thieu-b55/Easy-esp32-domotica-with-esp32-mesh/Schermafdruk_2023-03-04_16-17-45.png

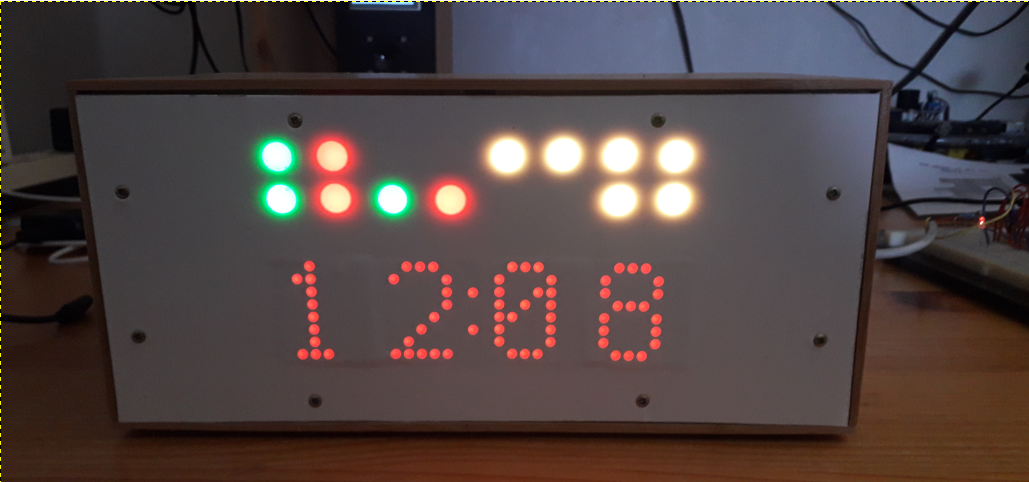
Schermafdruk_2023-03-04_16-17-45.png
