thieu-b55/Easy-esp32-domotica-with-esp32-mesh/README.md

# Easy-esp32-domotica-with-esp32-mesh

8 digital inputs

8 digital outputs

clock synchronized with NTP server

fully operable via web page

outputs can be controlled via

  day
  
  time on time off
  
  input
  
  combination of these 3
  
  manually
  
  network is build automatically, modules can be added or removed
  
  network rebuild itself
  
  Check every minute whether aal modules are still connected
  
  status of the various inputs and outputs clearly visible as well as the clock
