thieu-b55/Easy-esp32-domotica-with-esp32-mesh/Eenvoudig ESP32 domotica met ESP32 mesh netwerk.pdf

Domotica met ESP32 mesh netwerk

8 digitale ingangen
8 digitale uitgangen
klok gesynchroniseerd met NTP server volledig bedienbaar via webpagina uitgangen kunnen gestuurd worden via: – dag
– tijd
– ingang
– een combinatie van deze 3 – manueel
netwerk wordt automatisch opgebouwd, modules kunnen worden toegevoegd of verwijderd, netwerk bouwt zichzelf terug op.
Elke minuut controle of alle modules nog verbonden zijn


Status van de verschillende in en uitgangen duidelijk zichtbaar evenals de klok. Elke in- of uitgang heeft 4 mogelijkheden om weergegeven te worden,

* niet aktief | niet opgelicht
* aktief niet gestuurd (0) | groen
* aktief gestuurd(1) | rood
* aktief maar geen terugmelding | geel
van module met dit nummer

deze kleuren zijn identiek voor de webpagina


Enkele nuttige adressen

ESP32 en Arduino IDE :
https://randomnerdtutorials.com/installing-the-esp32-board-in-arduino-ide-windows-instructions/

ESP32 mesh / Hoe painlessMesh Library installeren : https://randomnerdtutorials.com/esp-mesh-esp32-esp8266-painlessmesh/#more-100202

ESP32 mesh :
https://docs.espressif.com/projects/esp-idf/en/stable/esp32/api-guides/esp-wifi-mesh.html

Dit project opgithub :
https://github.com/thieu-b55/Easy-esp32-domotica-with-esp32-mesh

ESP32 domotica

Onderdelen hoofdmodule

2 x ESP32 Devkit (ESP32 module kan niet gelijktijdig onderdeel zijn van een mesh netwerk en webserver zijn).


1x DS3231 klokmodule met SQW uitgang

1 x MAX7219 led display


Ledstrip 16 leds WS2812B
led 0 – 7 | uitgang | led 0 = uitgang 0 | led 7 = uitgang 7
led 8 – 15 | ingang | led 8 = ingang 0 | led 15 = ingang 7

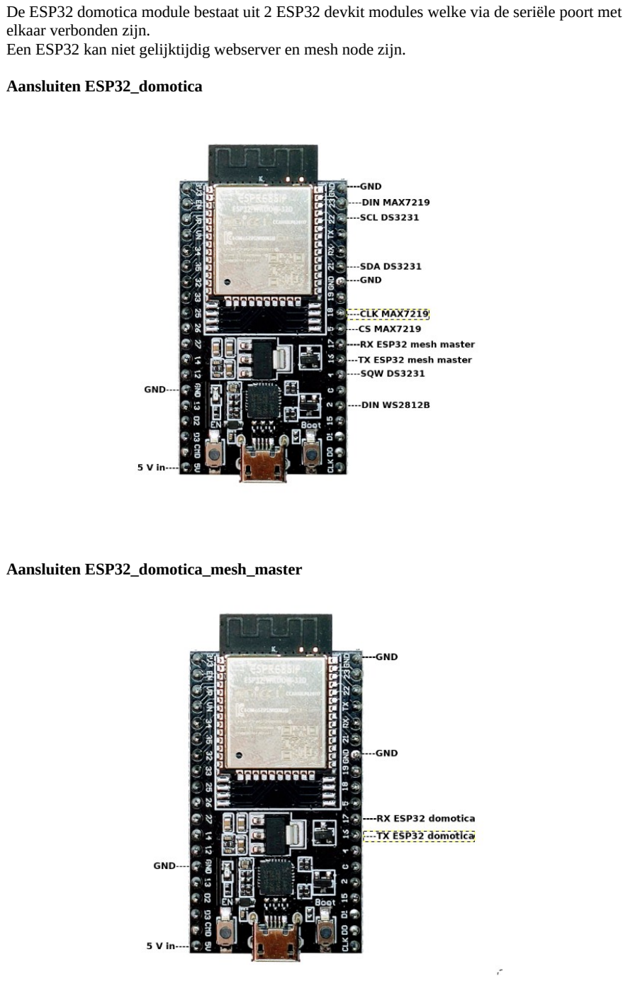
[picture p28: page 6]

De ESP32 domotica module bestaat uit 2 ESP32 devkit modules welke via de seriële poort met elkaar verbonden zijn.
Een ESP32 kan niet gelijktijdig webserver en mesh node zijn.

Aansluiten ESP32_domotica

Aansluiten ESP32_domotica_mesh_master

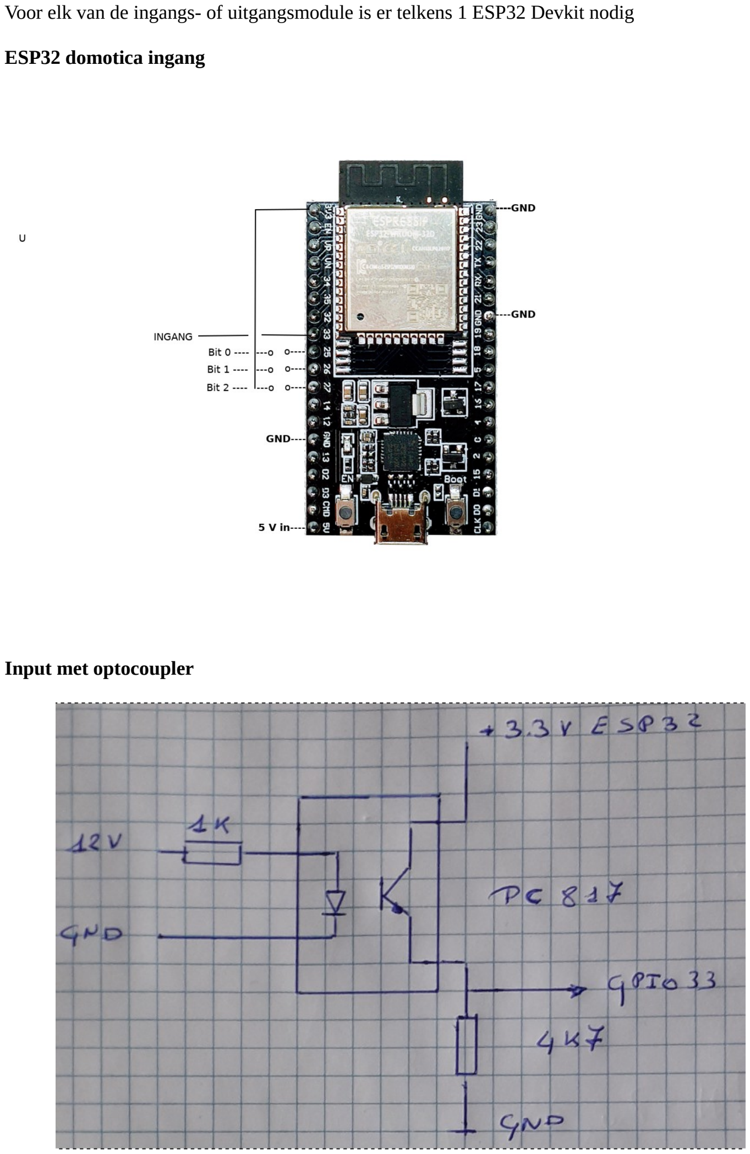
[picture p29: page 7]

Voor elk van de ingangs- of uitgangsmodule is er telkens 1 ESP32 Devkit nodig

ESP32 domotica ingang

Input met optocoupler

ESP32 domotica uitgang


Het adresseren van de modules gebeurt door Bit 0, Bit 1 en Bit 2 met de 3.3V te verbinden of niet

Adres | Bit 2 | Bit 1 | Bit 0
0 | 0 | 0 | 0
1 | 0 | 0 | 1
2 | 0 | 1 | 0
3 | 0 | 1 | 1
4 | 1 | 0 | 0
5 | 1 | 0 | 1
6 | 1 | 1 | 0
7 | 1 | 1 | 1

Elke ingangsmodule moet een uniek adres hebben 0-7 Elke uitgangsmodule moet een uniek adres hebben 0-7

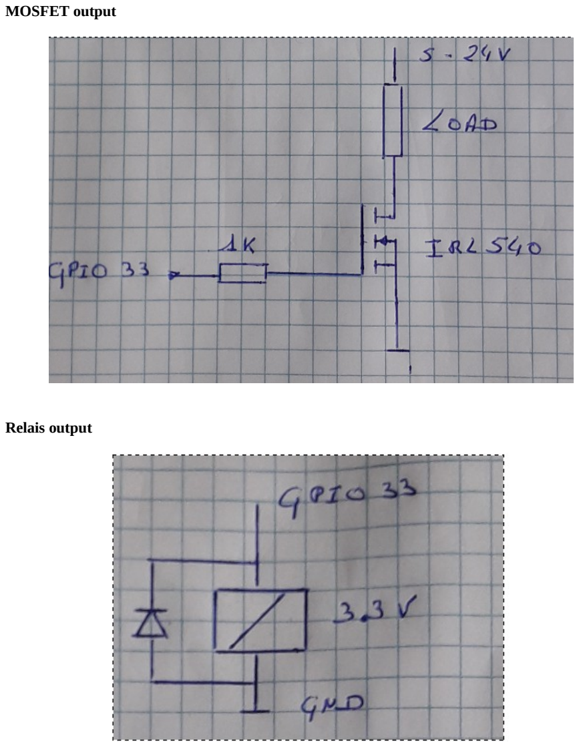
[picture p30: page 9]

MOSFET output

Relais output

ESP32 domotica
ESP32 domotica mesh master
DS3231
MAX7219
samen op een breadboard (alleen de onderste 2 modules)


Samen gebouwd in een behuizing

Bovenste 8 leds tonen de status van de ingangsmodules Onderste 8 leds tonen de status van de uitgangsmodules

Er zijn 4 mogelijkheden voor zowel in als uitgangen

geen licht | ingang of uitgang niet actief
geel | ingang of uitgang is actief maar geen terugmelding van een module met
| dit adres
groen | module actief en ingang / uitgang 0
rood | module actief en ingang / uitgang 1
meer uitleg of actief niet actief verder in deze handleiding.

3 uitgangsmodules
1 ingangsmodule
op breadboard


Na het bouwen, programmeren

Download van Github https://github.com/thieu-b55/Easy-esp32-domotica-with-esp32-mesh

Open het programma ESP32_domotica.ino met de Arduino IDE en gebruik de volgende instellingen


Programmeer de ESP32_domotica ESP32

Open het programma ESP32_domotica_mesh_master.ino in de Arduino IDE

De bovenstaande gegevens kunnen veranderd worden, alle modules van dit netwerk moeten echter dezelfde gegevens hebben

Gebruik de volgende instellingen


Programmeer de ESP32_domotica_mesh_master ESP32

Open het programma ESP32_domotica_ingang.ino in de Arduino IDE

De bovenstaande gegevens kunnen veranderd worden, alle modules van dit netwerk moeten echter dezelfde gegevens hebben

Gebruik de volgende instellingen


Kies het gewenste adres met behulp van GPIO25; GPIO26 en GPIO27, adres wordt alleen tijdens de opstart ingelezen.

Programmeer de ESP32_domotica_ingang ESP32

Open het programma ESP32_domotica_uitgang.ino in de Arduino IDE

De bovenstaande gegevens kunnen veranderd worden, alle modules van dit netwerk moeten echter dezelfde gegevens hebben

Gebruik de volgende instellingen


Kies het gewenste adres met behulp van GPIO25, GPIO26 en GPIO27, adres wordt alleen tijdens de opstart ingelezen.

Programmeer de ESP32_domotica_uitgang ESP32

Bij eerste gebruik moeten eerst de netwerk gegevens worden ingevuld. Maak verbinding met

Netwerk: | ESP32rc
Paswoord: | ESP32pswd

Open de webpagina op 192.168.4.1


Vul de gegevens in van WiFi netwerk, indien gewenst kan ook het IP adres worden aangepast, is ingesteld op 192.168.1.122

Druk op <Bevestig> ESP32 herstart na 5 seconden.

Netwerk ESP32rc niet meer beschikbaar, ga naar het WiFi netwerk en ga naar 192.168.1.122 of naar het zelf gekozen IP adres

Opstartscherm

Druk op<klok>



uren : tijdsverschil in uren tussen lokale tijd en UTC tijd (+ / –)
minuten : tijdsverschil in minuten (30 of 0) tussen lokale tijd en UTC (geen negatief) zomertijd : 1 indien nu zomertijd anders 0

Druk op <OK> om tijd aan te passen.

Led helderheid : 0 – 15 helderheid van de MAX7219 Druk op <OK> om aan te passen

Druk op <begin pagina>

Druk op <instellen>



Instellen uitgangen
kies met < – > en < + > de gewenste uitgang

Label : indien gewenst naam voor de uitgang (max 10 karakters)

Wanneer moet een uitgang schakelen:
Dag : 1 maandag
2 dinsdag
3 woensdag
4 donderdag
5 vrijdag
6 zaterdag
7 zondag
8 dagelijks
9 weekdagen
10 weekend
Aan : tijd om uitgang naar <1> te schakelen 24:00 tijdschakelen uit dienst
Uit : | tijd om uitgang naar <0> te schakelen
| indien Aan = 24:00 uit dienst
In : | gewenste ingang die <1> moet zijn alvorens uitgang <1> kan zijn
| x geen controle op ingang

druk op <Bevestig>

Doe dit voor alle gewenste uitgangen


Hetzelfde voor de ingangen
kies met < – > en < + > de gewenste ingang
Label : indien gewenst naam voor de ingang (max 10 karakters)

Druk <Bevestig>

Als alles is ingevuld druk op <begin pagina>


De software controleert elke minuut naar de aanwezige ingangen en uitgangen, bij opstart of bij wijziging van de configuratie kan het enkele minuten duren alvorens alle modules gevonden zijn.


Kleuren en hun betekenis zijn identiek voor de ledstrip als de webpagina

Voorbeeld van de beginpagina bij een configuratie met 5 actieve ingangen en 1 actieve ingang

actief >> uitgang kan gestuurd worden
ingang er wordt rekening gehouden met de toestand van de ingang

niet actief >> uitgang kan niet gestuurd worden
ingang er wordt geen rekening gehouden met een <1> van de ingang

Een uitgang / ingang wordt actief of niet actief geschakeld door op gewenste nummer van de uitgang / ingang te drukken

een niet actieve uitgang / ingang heeft de achtergrondkleur, voor de ledstrip <uit>

actief | geel | uitgang / ingang is actief maar (nog) geen terugmelding van een module met dit adres.

groen module heeft zich gemeld en de uitgang / ingang is <0>
| rood | module heeft zich gemeld en de uitgang / ingang is <1>

Wanneer schakelt een uitgang

Hier uitgang 0 <1>
uitgang is actief
en is manueel geschakeld
manueel drukken op het laatste vakje
achtergrondkleur | >> uitgang afhankelijk van de voorwaarden
blauw | >> uitgang manueel op <1> (indien actief)

Hier uitgang 1 <1>
uitgang is actief
dag = 8 >> alle dagen
aan = 24:00 tijd uitgeschakeld
in = x geen ingang gespecificeerd

uitgang 3 <1>
actief
dag = 8
tijd = 24:00
in = ingang 1


ingang 1 <1> rood

uitgang =
actief and dag and aan and not uit and in of
actief and manueel

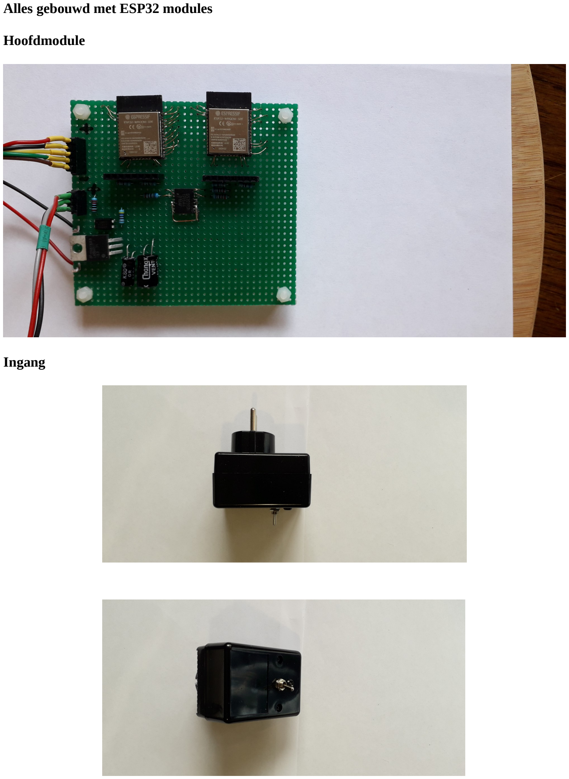
[picture p31: page 26]

Alles gebouwd met ESP32 modules

Hoofdmodule

Ingang

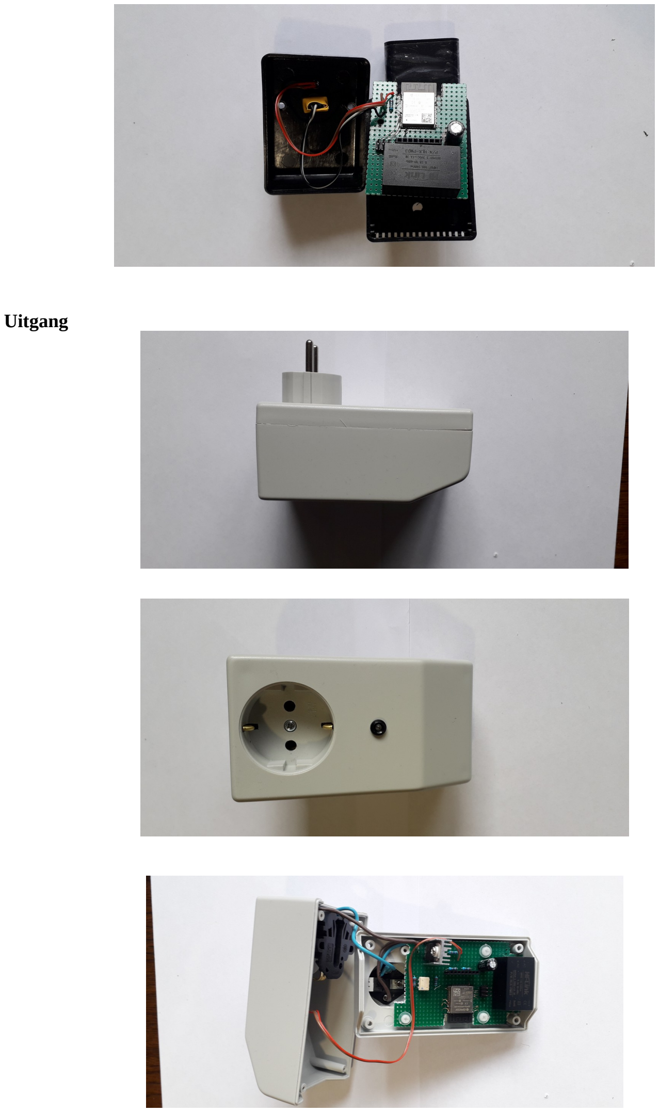
[picture p32: page 27]

Uitgang

Dat was het,
groeten,
thieu-b55
