thieu-b55/Easy-esp32-domotica-with-esp32-mesh/Screenshot_20230227-112725_Samsung Internet.jpg

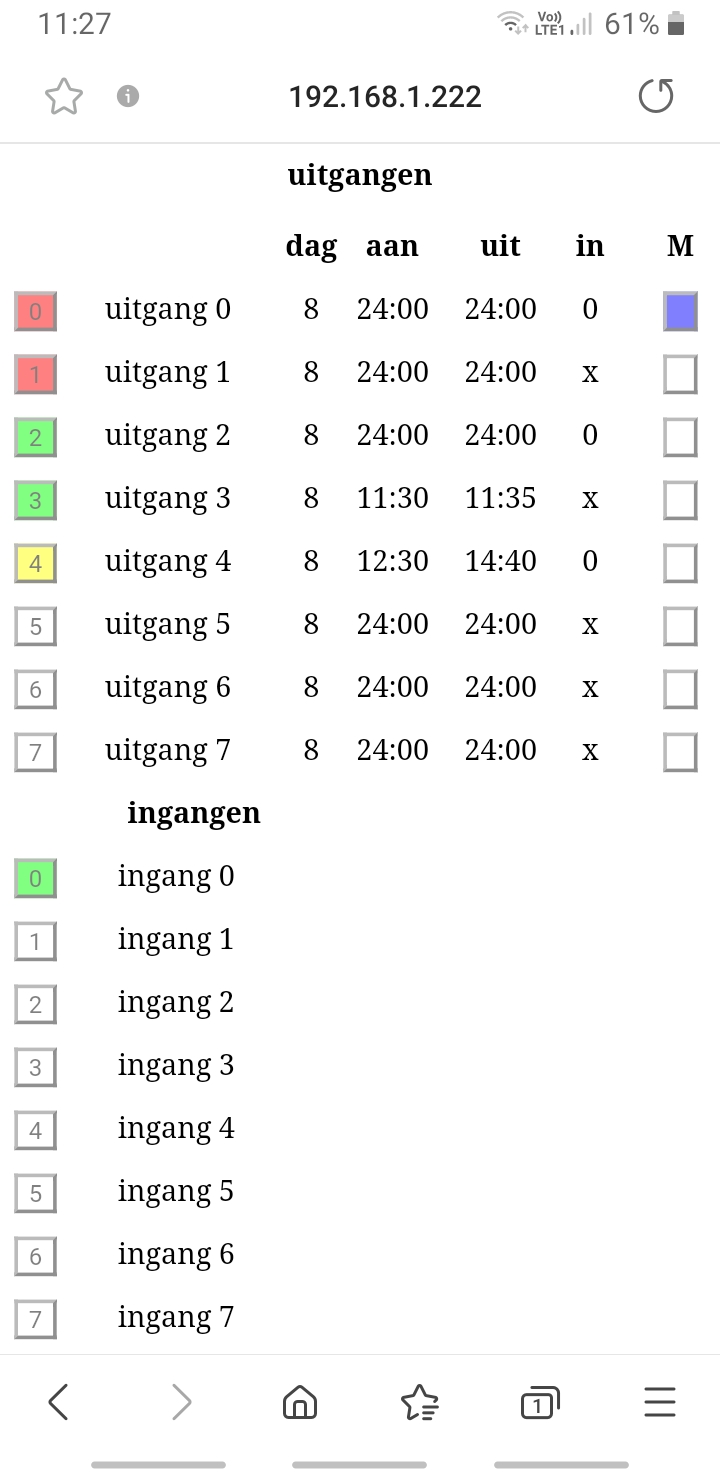
Screenshot_20230227-112725_Samsung Internet.jpg
